henrynester/FIRES-hardware/battery-board.kicad_pcb

## KiCad design battery-board.kicad_pcb (2025-03-20)

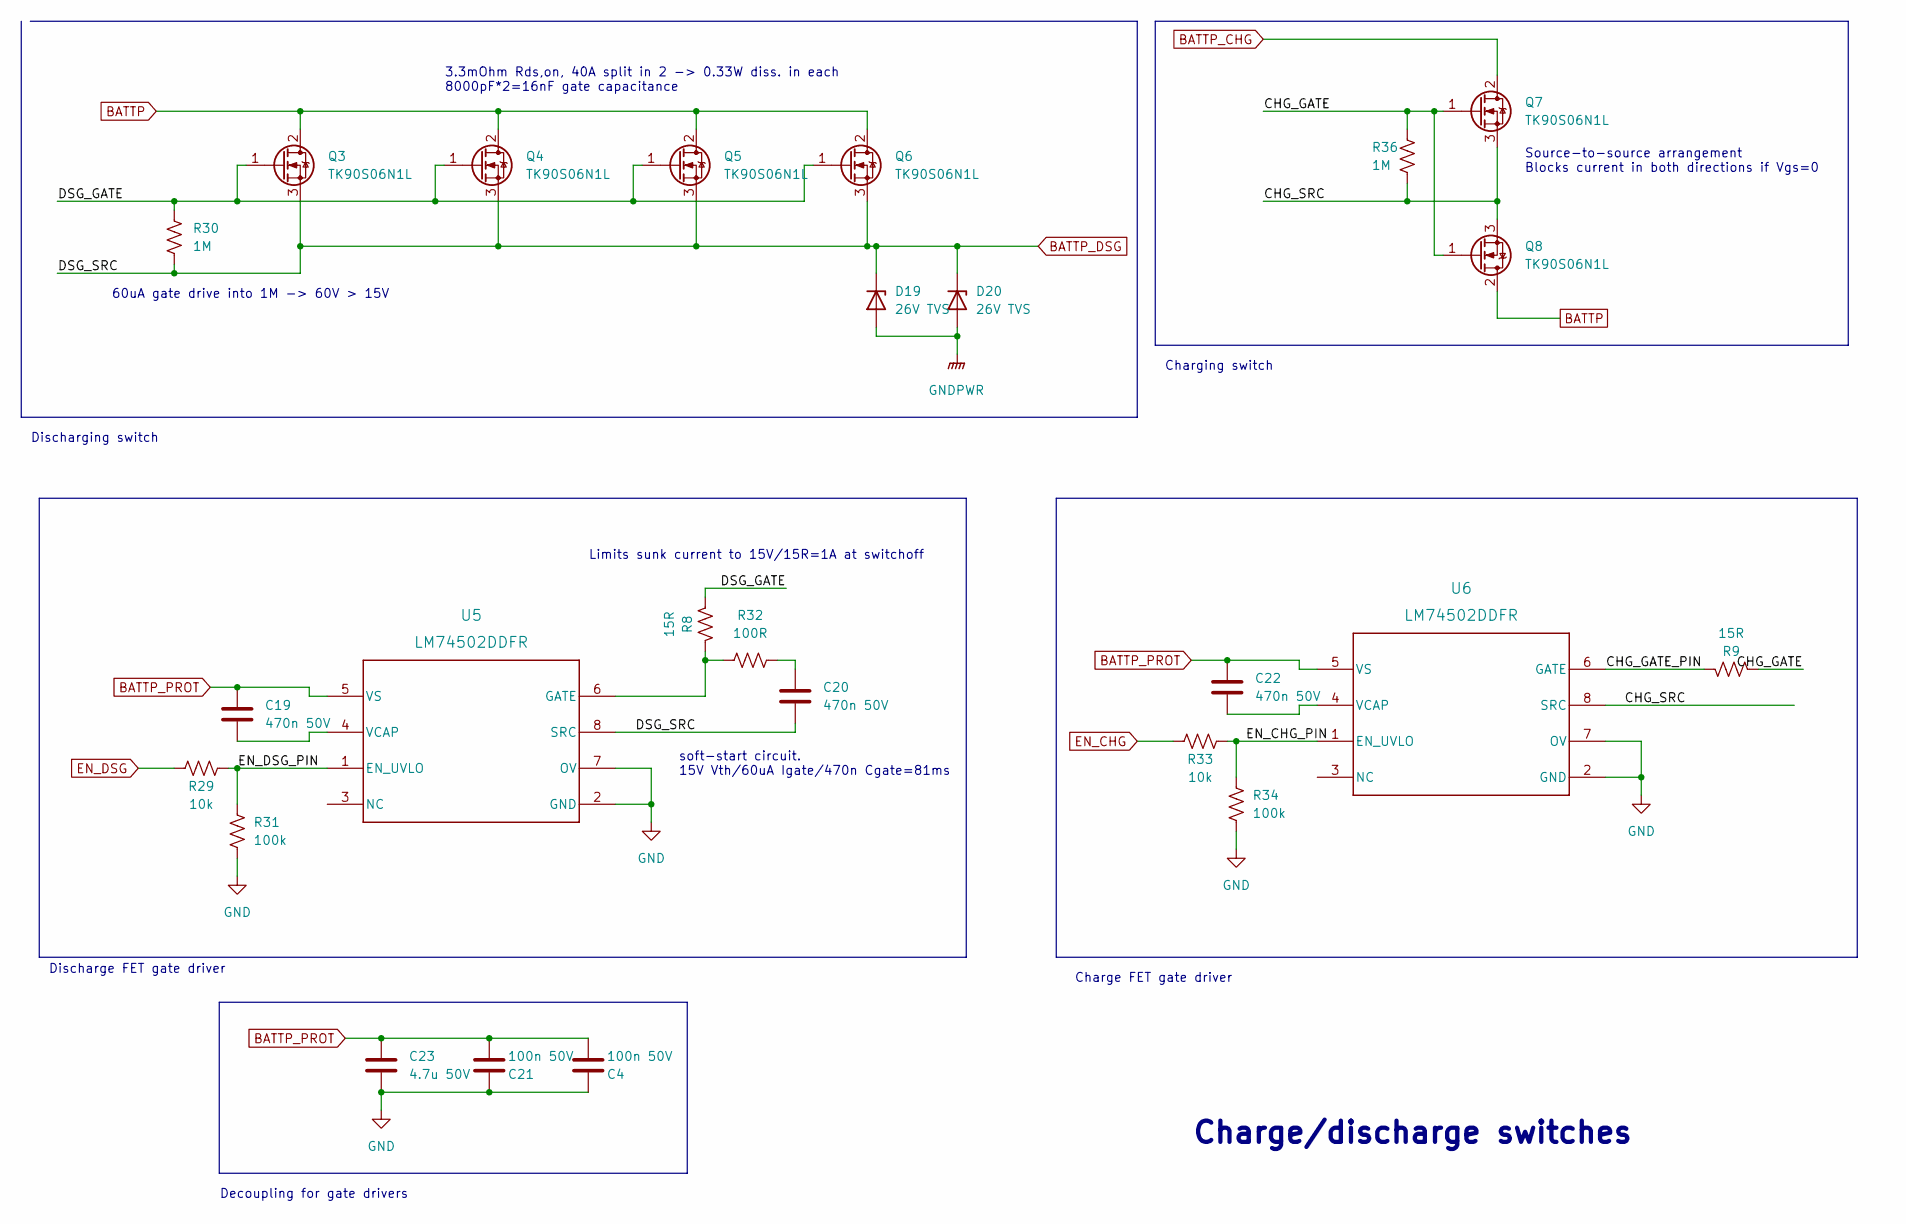
[picture p9: schematic load_switch.kicad_sch]

Parts:
C4, C21: 100n 50V; C_0805_2012Metric; part_number GCD21BR71H104KA01L
C19, C20, C22: 470n 50V; C_0805_2012Metric_Pad1.18x1.45mm_HandSolder; part_number GRM21BR71H474KA88L
C23: 4.7u 50V; C_1206_3216Metric_Pad1.33x1.80mm_HandSolder; part_number GRM31CR71H475KA12L
D19, D20: 26V TVS; D_SMB; part_number SMBJ26A
Q3, Q4, Q5, Q6, Q7, Q8: TK90S06N1L; TO-252-2; part_number TK90S06N1L,LXHQ
R8, R9: 15R; R_0805_2012Metric_Pad1.20x1.40mm_HandSolder; part_number RC0805FR-1310KL
R29, R33: 10k; R_0805_2012Metric_Pad1.20x1.40mm_HandSolder; part_number RC0805FR-1310KL
R30, R36: 1M; R_0805_2012Metric_Pad1.20x1.40mm_HandSolder; part_number RC0805FR-071ML
R31, R34: 100k; R_0805_2012Metric_Pad1.20x1.40mm_HandSolder; part_number RC0805FR-07100KL
R32: 100R; R_0805_2012Metric_Pad1.20x1.40mm_HandSolder; part_number RC0805FR-07100RL
U5, U6: LM74502DDFR; LM74502; part_number LM74502DDFR

Connections:
/load_switch/CHG_GATE: Q7.1 (G), Q8.1 (G), R9.2, R36.1
/load_switch/CHG_GATE_PIN: R9.1, U6.6 (GATE)
/load_switch/CHG_SRC: Q7.3 (S), Q8.3 (S), R36.2, U6.8 (SRC)
/load_switch/DSG_GATE: Q3.1 (G), Q4.1 (G), Q5.1 (G), Q6.1 (G), R8.2, R30.1
/load_switch/EN_CHG_PIN: R33.2, R34.1, U6.1 (EN_UVLO)
/load_switch/EN_DSG_PIN: R29.2, R31.1, U5.1 (EN_UVLO)
BATTN: C4.1, C21.1, C23.2, R31.2, R34.2, U5.2 (GND), U5.7 (OV), U6.2 (GND), U6.7 (OV); also elsewhere on the board
BATTP: Q3.2 (D), Q4.2 (D), Q5.2 (D), Q6.2 (D), Q8.2 (D); also elsewhere on the board
BATTP_CHG: Q7.2 (D); also elsewhere on the board
BATTP_DSG: C20.2, D19.1 (K), D20.1 (K), Q3.3 (S), Q4.3 (S), Q5.3 (S), Q6.3 (S), R30.2, U5.8 (SRC); also elsewhere on the board
BATTP_PROT: C4.2, C19.1, C21.2, C22.1, C23.1, U5.5 (VS), U6.5 (VS); also elsewhere on the board
EN_CHG: R33.1; also elsewhere on the board
EN_DSG: R29.1; also elsewhere on the board
GNDPWR: D19.2 (A), D20.2 (A); also elsewhere on the board
unnamed: C19.2, U5.4 (VCAP)
unnamed: C20.1, R32.2
unnamed: C22.2, U6.4 (VCAP)
unnamed: R8.1, R32.1, U5.6 (GATE)

Notes on the sheet:
Charge FET gate driver
Decoupling for gate drivers
soft-start circuit. 15V Vth/60uA Igate/470n Cgate=81ms
Charging switch
Charge/discharge switches
Discharging switch
Discharge FET gate driver
Source-to-source arrangement Blocks current in both directions if Vgs=0
Limits sunk current to 15V/15R=1A at switchoff
60uA gate drive into 1M -> 60V > 15V
3.3mOhm Rds,on, 40A split in 2 -> 0.33W diss. in each 8000pF*2=16nF gate capacitance

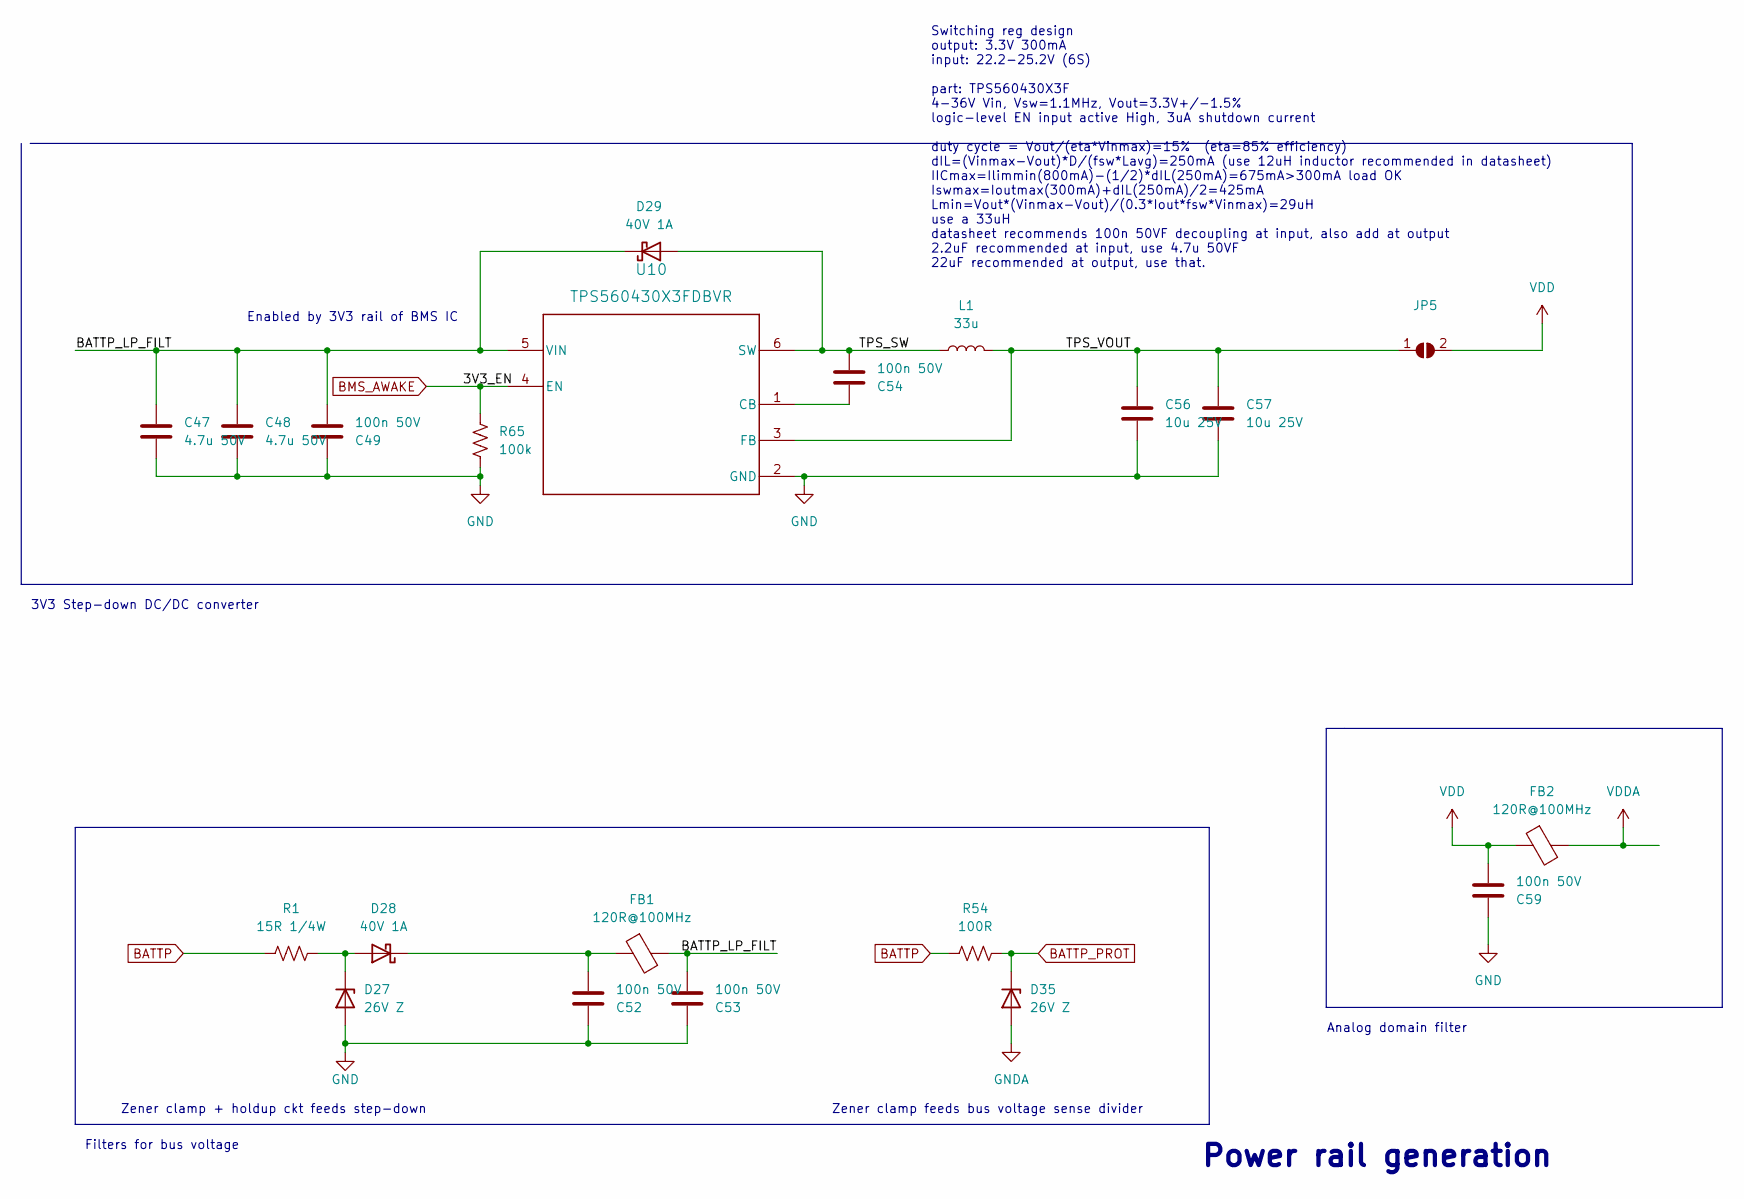
[picture p10: schematic rails.kicad_sch]

Parts:
C47, C48: 4.7u 50V; C_1206_3216Metric_Pad1.33x1.80mm_HandSolder; part_number GRM31CR71H475KA12L
C49, C52, C53, C54, C59: 100n 50V; C_0805_2012Metric; part_number GCD21BR71H104KA01L
C56, C57: 10u 25V; C_1206_3216Metric_Pad1.33x1.80mm_HandSolder; part_number GRM31CR71E106KA12L
D27, D35: 26V Z; D_SOD-123; part_number DDZ26-7
D28, D29: 40V 1A; D_SOD-323_HandSoldering; part_number 1N5819WS
FB1, FB2: 120R@100MHz; R_0805_2012Metric; part_number HI0805O121R-10
JP5: SolderJumper-2_P1.3mm_Open_Pad1.0x1.5mm
L1: 33u; L_Taiyo-Yuden_NR-60xx; part_number NR6028T330M
R1: 15R 1/4W; R_0805_2012Metric_Pad1.20x1.40mm_HandSolder; part_number AC0805FR-7W15RL
R54: 100R; R_0805_2012Metric_Pad1.20x1.40mm_HandSolder; part_number RC0805FR-07100RL
R65: 100k; R_0805_2012Metric_Pad1.20x1.40mm_HandSolder; part_number RC0805FR-07100KL
U10: TPS560430X3FDBVR; SOT-23-6_Handsoldering; part_number TPS560430X3FDBVR

Connections:
/rails/BATTP_LP_FILT: C47.1, C48.1, C49.2, C53.2, D29.1 (K), FB1.2, U10.5 (VIN)
/rails/TPS_SW: C54.2, D29.2 (A), L1.1, U10.6 (SW)
/rails/TPS_VOUT: C56.1, C57.1, JP5.1 (A), L1.2, U10.3 (FB)
BATTN: C47.2, C48.2, C49.1, C52.1, C53.1, C56.2, C57.2, C59.1, D27.2 (A), D35.2 (A), R65.1, U10.2 (GND); also elsewhere on the board
BATTP: R1.1, R54.1; also elsewhere on the board
BATTP_PROT: D35.1 (K), R54.2; also elsewhere on the board
BMS_AWAKE: R65.2, U10.4 (EN); also elsewhere on the board
unnamed: C52.2, D28.1 (K), FB1.1
unnamed: C54.1, U10.1 (CB)
unnamed: D27.1 (K), D28.2 (A), R1.2
VDD: C59.2, FB2.1, JP5.2 (B); also elsewhere on the board
VDDA: FB2.2; also elsewhere on the board

Notes on the sheet:
3V3 Step-down DC/DC converter
Analog domain filter
Zener clamp feeds bus voltage sense divider
Power rail generation
Switching reg design output: 3.3V 300mA input: 22.2-25.2V (6S) part: TPS560430X3F 4-36V Vin, Vsw=1.1MHz, Vout=3.3V+/-1.5% logic-level EN input active High, 3uA shutdown current duty cycle = Vout/(eta*Vinmax)=15% (eta=85% efficiency) dIL=(Vinmax-Vout)*D/(fsw*Lavg)=250mA (use 12uH inductor recommende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
Filters for bus voltage
Zener clamp + holdup ckt feeds step-down
Enabled by 3V3 rail of BMS IC

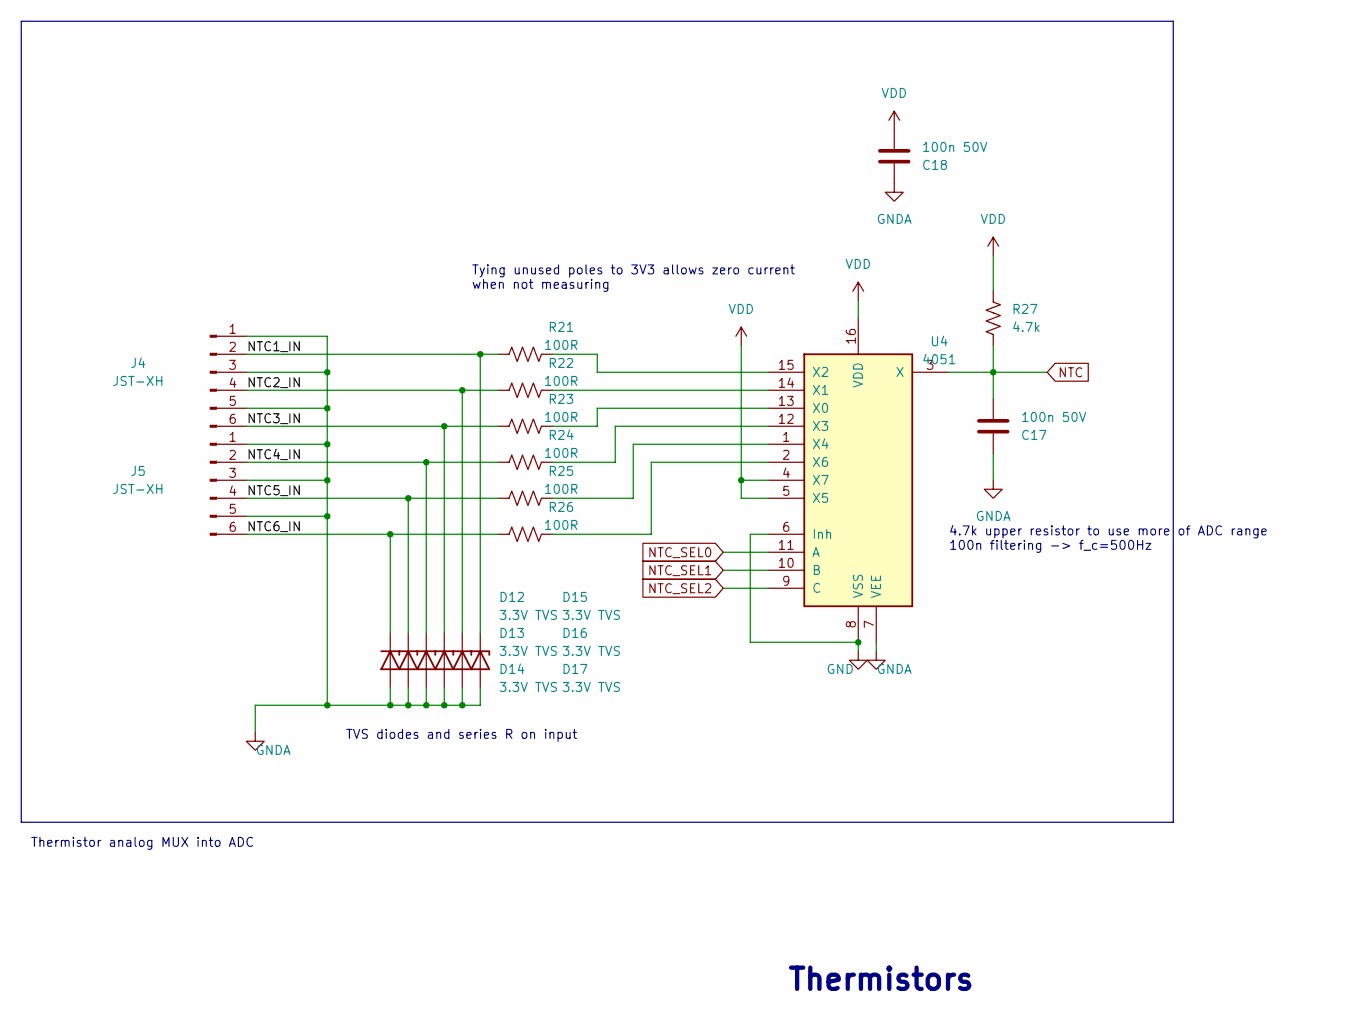
[picture p11: schematic thermistors.kicad_sch]

Parts:
C17, C18: 100n 50V; C_0805_2012Metric; part_number GCD21BR71H104KA01L
D12, D13, D14, D15, D16, D17: 3.3V TVS; D_SOD-323_HandSoldering; part_number ESD5Z3.3T5G
J4, J5: JST-XH; JST_XH_B6B-XH-A_1x06_P2.50mm_Vertical
R21, R22, R23, R24, R25, R26: 100R; R_0805_2012Metric_Pad1.20x1.40mm_HandSolder; part_number RC0805FR-07100RL
R27: 4.7k; R_0805_2012Metric_Pad1.20x1.40mm_HandSolder; part_number RC0805FR-074K7L
U4: 4051; TSSOP-16_4.4x5mm_P0.65mm; part_number CD74HC4051PWR

Connections:
/thermistors/NTC1_IN: D17.1 (K), J4.2, R21.2
/thermistors/NTC2_IN: D16.1 (K), J4.4, R22.2
/thermistors/NTC3_IN: D15.1 (K), J4.6, R23.2
/thermistors/NTC4_IN: D14.1 (K), J5.2, R24.2
/thermistors/NTC5_IN: D13.1 (K), J5.4, R25.2
/thermistors/NTC6_IN: D12.1 (K), J5.6, R26.2
BATTN: C17.1, C18.1, D12.2 (A), D13.2 (A), D14.2 (A), D15.2 (A), D16.2 (A), D17.2 (A), J4.1, J4.3, J4.5, J5.1, J5.3, J5.5, U4.6 (Inh), U4.7 (VEE), U4.8 (VSS); also elsewhere on the board
NTC: C17.2, R27.2, U4.3 (X); also elsewhere on the board
NTC_SEL0: U4.11 (A); also elsewhere on the board
NTC_SEL1: U4.10 (B); also elsewhere on the board
NTC_SEL2: U4.9 (C); also elsewhere on the board
unnamed: R21.1, U4.15 (X2)
unnamed: R22.1, U4.14 (X1)
unnamed: R23.1, U4.13 (X0)
unnamed: R24.1, U4.12 (X3)
unnamed: R25.1, U4.1 (X4)
unnamed: R26.1, U4.2 (X6)
VDD: C18.2, R27.1, U4.4 (X7), U4.5 (X5), U4.16 (VDD); also elsewhere on the board

Notes on the sheet:
TVS diodes and series R on input
4.7k upper resistor to use more of ADC range 100n filtering -> f_c=500Hz
Tying unused poles to 3V3 allows zero current when not measuring
Thermistors
Thermistor analog MUX into ADC

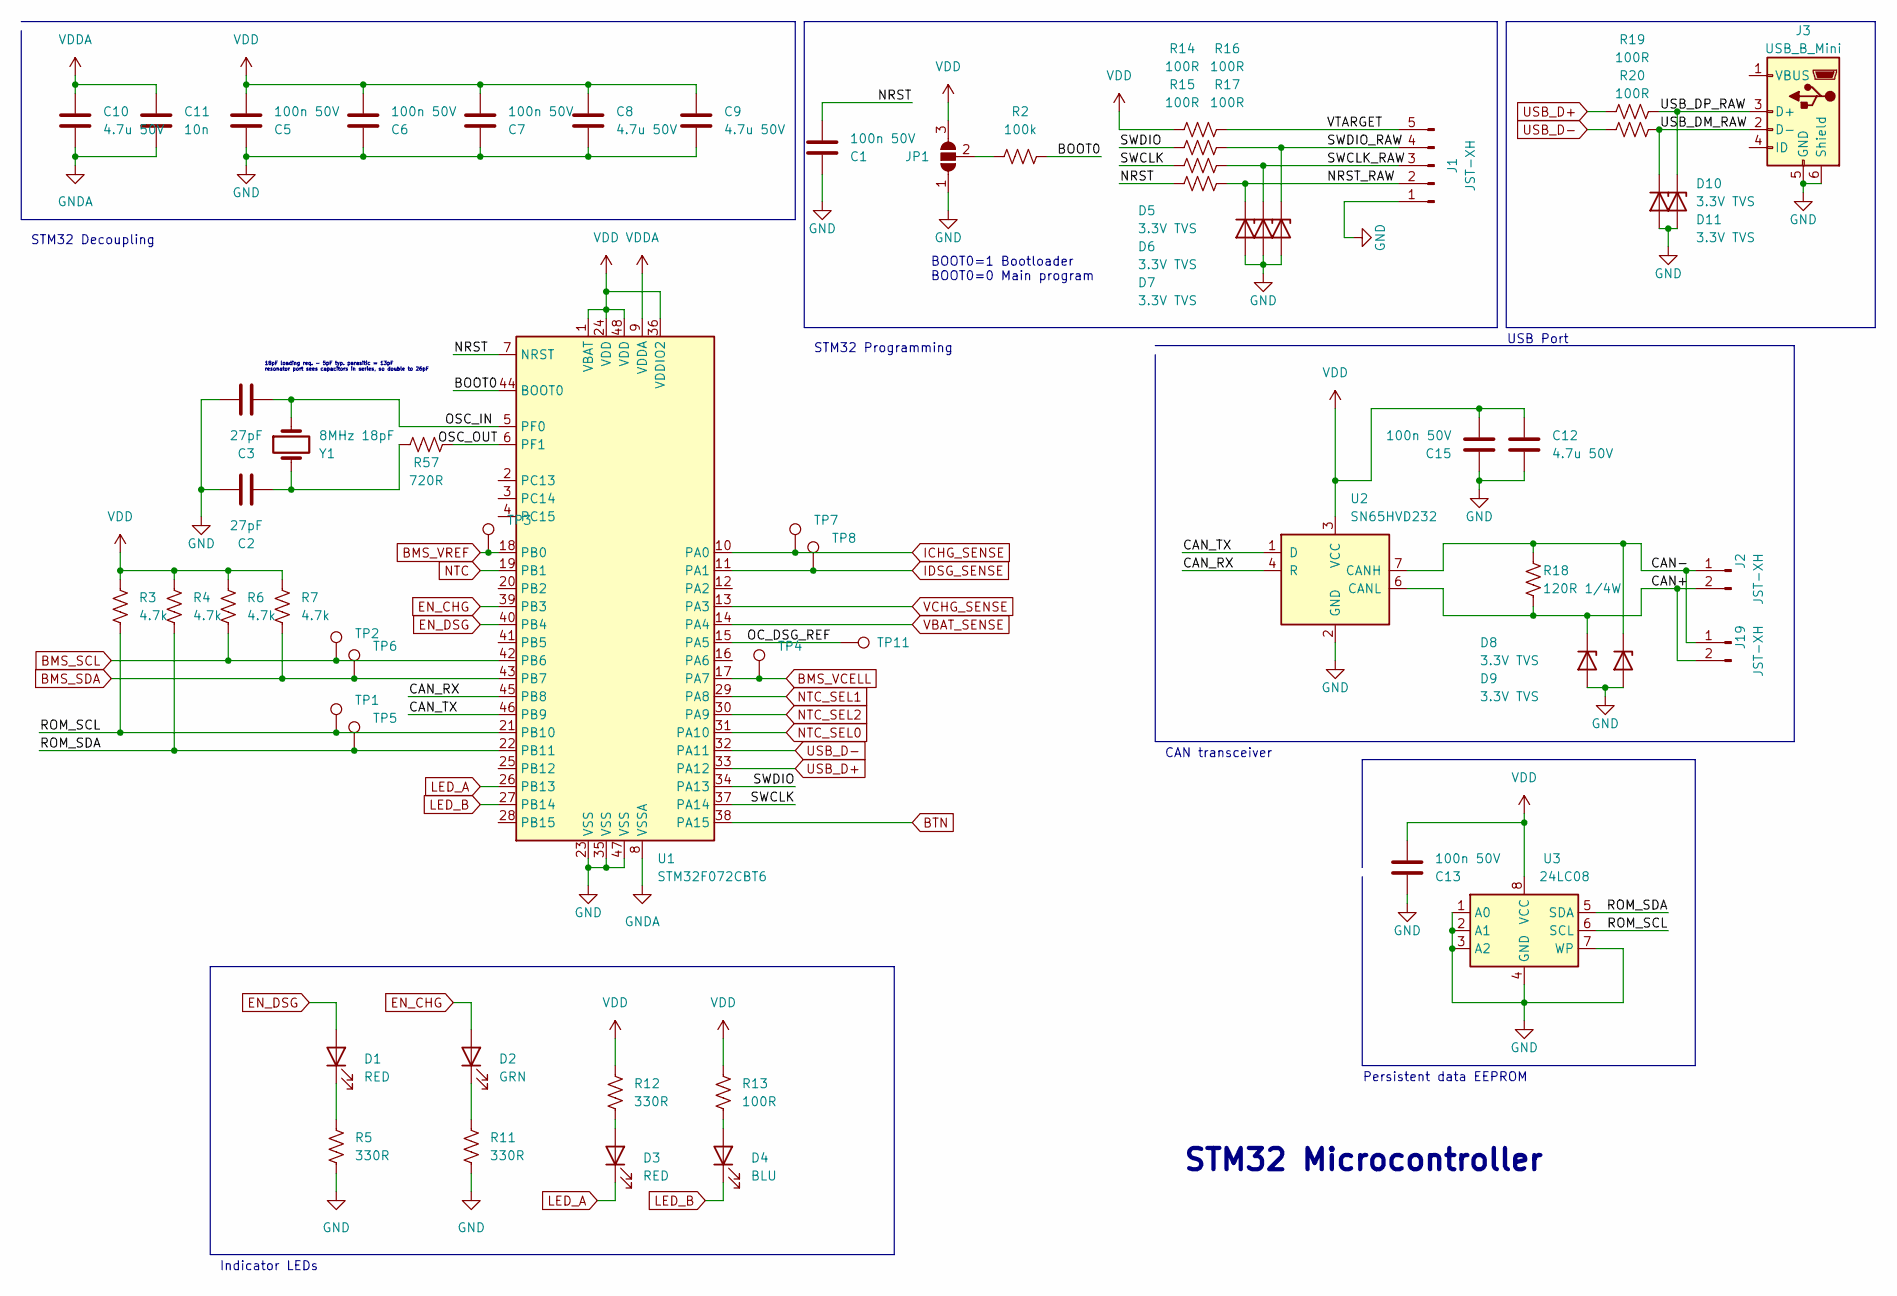
[picture p12: schematic MCU.kicad_sch]

Parts:
C1, C5, C6, C7, C13, C15: 100n 50V; C_0805_2012Metric; part_number GCD21BR71H104KA01L
C2, C3: 27pF; C_0805_2012Metric_Pad1.18x1.45mm_HandSolder; part_number CC0805FRNPO9BN270
C8, C9, C10, C12: 4.7u 50V; C_1206_3216Metric_Pad1.33x1.80mm_HandSolder; part_number GRM31CR71H475KA12L
C11: 10n; R_0805_2012Metric_Pad1.20x1.40mm_HandSolder; part_number GCM219R71H103KA37D
D1, D3: RED; LED_0805_2012Metric_Pad1.15x1.40mm_HandSolder; part_number LTST-C171KRKT
D2: GRN; LED_0805_2012Metric_Pad1.15x1.40mm_HandSolder; part_number LTST-C171GKT
D4: BLU; LED_0805_2012Metric_Pad1.15x1.40mm_HandSolder; part_number LTST-C171TBKT
D5, D6, D7, D8, D9, D10, D11: 3.3V TVS; D_SOD-323_HandSoldering; part_number ESD5Z3.3T5G
J1: JST-XH; PinHeader_1x05_P2.54mm_Vertical
J2, J19: JST-XH; JST_XH_B2B-XH-A_1x02_P2.50mm_Vertical
J3: USB_B_Mini; USB_Mini-B_Tensility_54-00023_Vertical; part_number 54-00023
JP1: SolderJumper-3_P1.3mm_Open_Pad1.0x1.5mm
R2: 100k; R_0805_2012Metric_Pad1.20x1.40mm_HandSolder; part_number RC0805FR-07100KL
R3, R4, R6, R7: 4.7k; R_0805_2012Metric_Pad1.20x1.40mm_HandSolder; part_number RC0805FR-074K7L
R5, R11, R12: 330R; R_0805_2012Metric_Pad1.20x1.40mm_HandSolder; part_number RC0805FR-07100RL
R13, R14, R15, R16, R17, R19, R20: 100R; R_0805_2012Metric_Pad1.20x1.40mm_HandSolder; part_number RC0805FR-07100RL
R18: 120R 1/4W; R_0805_2012Metric_Pad1.20x1.40mm_HandSolder; part_number RC0805FR-7W120RL
R57: 720R; R_0805_2012Metric_Pad1.20x1.40mm_HandSolder; part_number RC0805FR-07100RL
TP1, TP2, TP3, TP4, TP5, TP6, TP7, TP8: PinHeader_1x01_P1.00mm_Vertical
TP11: TestPoint; TestPoint_Pad_D1.0mm
U1: STM32F072CBT6; LQFP-48_7x7mm_P0.5mm; part_number STM32F072CBT6
U2: SN65HVD232; SOIC-8_3.9x4.9mm_P1.27mm; part_number SN65HVD232
U3: 24LC08; SOIC-8_3.9x4.9mm_P1.27mm; part_number 24LC08BT-I/SN
Y1: 8MHz 18pF; Crystal_SMD_HC49-SD; part_number ABLS-8.000MHZ-D-T

Connections:
/MCU/BOOT0: R2.2, U1.44 (BOOT0)
/MCU/CAN+: D8.1 (K), J2.2, J19.2, R18.2, U2.6 (CANL)
/MCU/CAN-: D9.1 (K), J2.1, J19.1, R18.1, U2.7 (CANH)
/MCU/CAN_RX: U1.45 (PB8), U2.4 (R)
/MCU/CAN_TX: U1.46 (PB9), U2.1 (D)
/MCU/NRST: C1.2, R17.2, U1.7 (NRST)
/MCU/NRST_RAW: D5.1 (K), J1.2, R17.1
/MCU/OC_DSG_REF: TP11.1, U1.15 (PA5)
/MCU/OSC_IN: C3.2, U1.5 (PF0), Y1.1
/MCU/OSC_OUT: R57.2, U1.6 (PF1)
/MCU/ROM_SCL: R3.2, TP1.1, U1.21 (PB10), U3.6 (SCL)
/MCU/ROM_SDA: R4.2, TP5.1, U1.22 (PB11), U3.5 (SDA)
/MCU/SWCLK: R16.2, U1.37 (PA14)
/MCU/SWCLK_RAW: D6.1 (K), J1.3, R16.1
/MCU/SWDIO: R15.2, U1.34 (PA13)
/MCU/SWDIO_RAW: D7.1 (K), J1.4, R15.1
/MCU/USB_DM_RAW: D10.1 (K), J3.2 (D-), R20.1
/MCU/USB_DP_RAW: D11.1 (K), J3.3 (D+), R19.1
/MCU/VTARGET: J1.5, R14.1
BATTN: C1.1, C2.1, C3.1, C5.1, C6.1, C7.1, C8.2, C9.2, C10.2, C11.2, C12.2, C13.1, C15.1, D5.2 (A), D6.2 (A), D7.2 (A), D8.2 (A), D9.2 (A), D10.2 (A), D11.2 (A), J1.1, J3.5 (GND), J3.6 (Shield), JP1.1 (A), R5.1, R11.1, U1.8 (VSSA), U1.23 (VSS), U1.35 (VSS), U1.47 (VSS), U2.2 (GND), U3.1 (A0), U3.2 (A1), U3.3 (A2), U3.4 (GND), U3.7 (WP); also elsewhere on the board
BMS_SCL: R6.2, TP2.1, U1.42 (PB6); also elsewhere on the board
BMS_SDA: R7.2, TP6.1, U1.43 (PB7); also elsewhere on the board
BMS_VCELL: TP4.1, U1.17 (PA7); also elsewhere on the board
BMS_VREF: TP3.1, U1.18 (PB0); also elsewhere on the board
BTN: U1.38 (PA15); also elsewhere on the board
EN_CHG: D2.2 (A), U1.39 (PB3); also elsewhere on the board
EN_DSG: D1.2 (A), U1.40 (PB4); also elsewhere on the board
ICHG_SENSE: TP7.1, U1.10 (PA0); also elsewhere on the board
IDSG_SENSE: TP8.1, U1.11 (PA1); also elsewhere on the board
LED_A: D3.1 (K), U1.26 (PB13)
LED_B: D4.1 (K), U1.27 (PB14)
NTC: U1.19 (PB1); also elsewhere on the board
NTC_SEL0: U1.31 (PA10); also elsewhere on the board
NTC_SEL1: U1.29 (PA8); also elsewhere on the board
NTC_SEL2: U1.30 (PA9); also elsewhere on the board
unnamed: C2.2, R57.1, Y1.2
unnamed: D1.1 (K), R5.2
unnamed: D2.1 (K), R11.2
unnamed: D3.2 (A), R12.1
unnamed: D4.2 (A), R13.1
unnamed: JP1.2 (C), R2.1
USB_D+: R19.2, U1.33 (PA12)
USB_D-: R20.2, U1.32 (PA11)
VBAT_SENSE: U1.14 (PA4); also elsewhere on the board
VCHG_SENSE: U1.13 (PA3); also elsewhere on the board
VDD: C5.2, C6.2, C7.2, C8.1, C9.1, C12.1, C13.2, C15.2, JP1.3 (B), R3.1, R4.1, R6.1, R7.1, R12.2, R13.2, R14.2, U1.1 (VBAT), U1.24 (VDD), U1.36 (VDDIO2), U1.48 (VDD), U2.3 (VCC), U3.8 (VCC); also elsewhere on the board
VDDA: C10.1, C11.1, U1.9 (VDDA); also elsewhere on the board

Notes on the sheet:
Persistent data EEPROM
USB Port
18pF loading req. - 5pF typ. parasitic = 13pF resonator port sees capacitors in series, so double to 26pF
BOOT0=1 Bootloader BOOT0=0 Main program
STM32 Programming
Indicator LEDs
CAN transceiver
STM32 Decoupling
STM32 Microcontroller

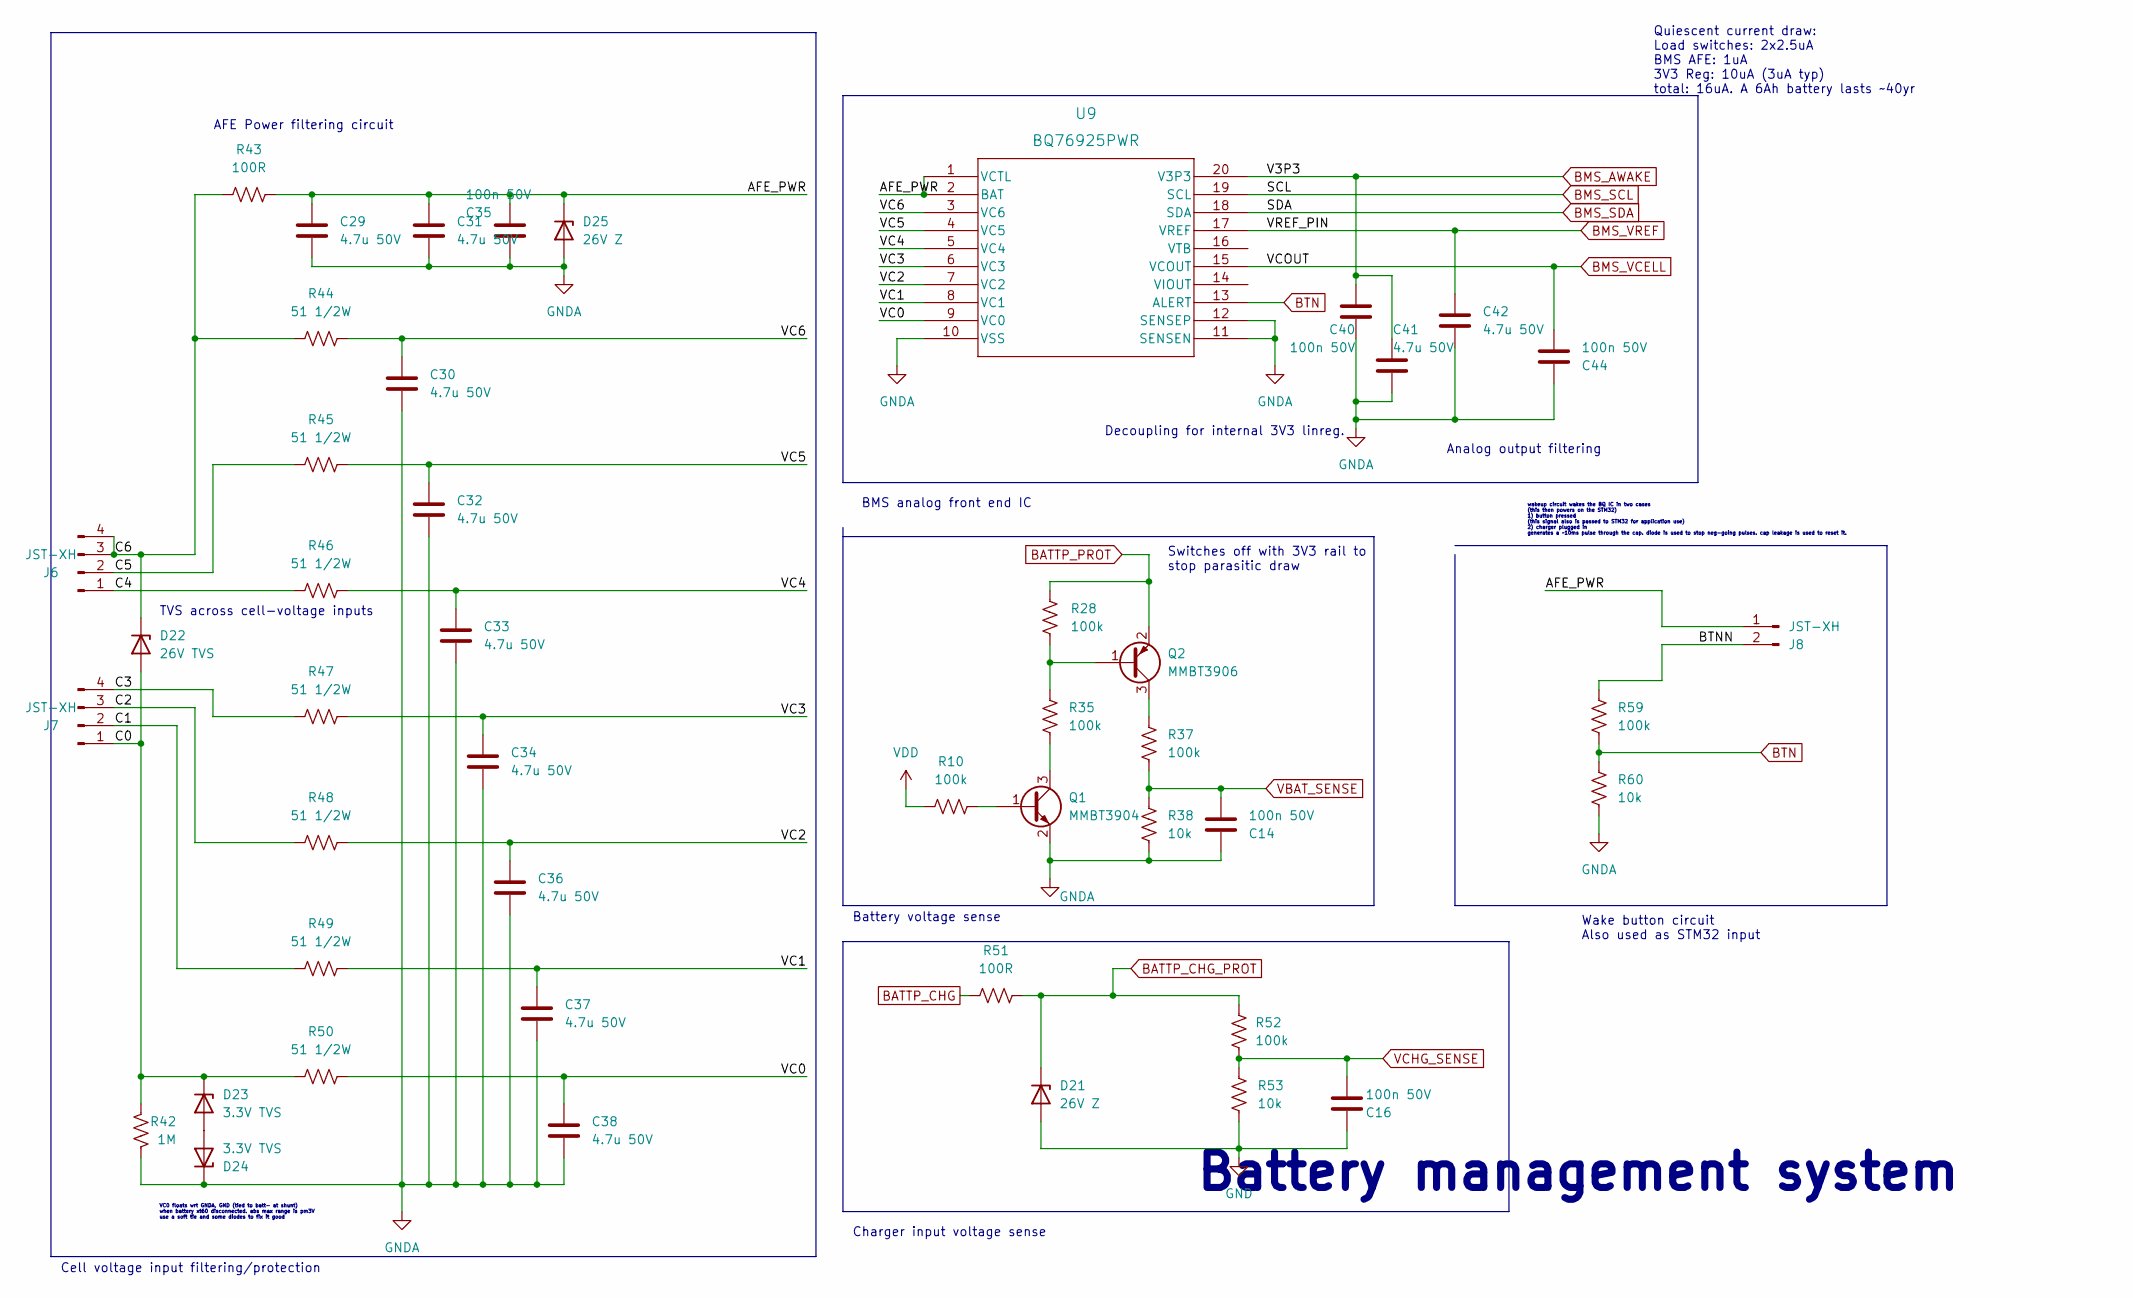
[picture p13: schematic battery_management.kicad_sch]

Parts:
C14, C16, C35, C40, C44: 100n 50V; C_0805_2012Metric; part_number GCD21BR71H104KA01L
C29, C30, C31, C32, C33, C34, C36, C37, C38, C41, C42: 4.7u 50V; C_1206_3216Metric_Pad1.33x1.80mm_HandSolder; part_number GRM31CR71H475KA12L
D21, D25: 26V Z; D_SOD-123; part_number DDZ26-7
D22: 26V TVS; D_SMB_Handsoldering; part_number SMBJ26A
D23, D24: 3.3V TVS; D_SOD-323_HandSoldering; part_number ESD5Z3.3T5G
J6, J7: JST-XH; JST_XH_B4B-XH-A_1x04_P2.50mm_Vertical
J8: JST-XH; JST_XH_B2B-XH-A_1x02_P2.50mm_Vertical
Q1: MMBT3904; SOT-23; part_number MMBT3904
Q2: MMBT3906; SOT-23; part_number MMBT3906
R10, R28, R35, R37, R52, R59: 100k; R_0805_2012Metric_Pad1.20x1.40mm_HandSolder; part_number RC0805FR-07100KL
R38, R53, R60: 10k; R_0805_2012Metric_Pad1.20x1.40mm_HandSolder; part_number RC0805FR-1310KL
R42: 1M; R_0805_2012Metric_Pad1.20x1.40mm_HandSolder; part_number RC0805FR-071ML
R43, R51: 100R; R_0805_2012Metric_Pad1.20x1.40mm_HandSolder; part_number RC0805FR-07100RL
R44, R45, R46, R47, R48, R49, R50: 51 1/2W; R_1206_3216Metric_Pad1.30x1.75mm_HandSolder; part_number CRM1206-FX-51R0ELF
U9: BQ76925PWR; BQ76925; part_number BQ76925PWR

Connections:
/battery_management/AFE_PWR: C29.1, C31.1, C35.2, D25.1 (K), J8.1, R43.2, U9.1 (VCTL), U9.2 (BAT)
/battery_management/BTNN: J8.2, R59.1
/battery_management/C0: D22.2 (A), D23.1 (K), J7.1, R42.1, R50.2
/battery_management/C1: J7.2, R49.2
/battery_management/C2: J7.3, R48.2
/battery_management/C3: J7.4, R47.2
/battery_management/C4: J6.1, R46.2
/battery_management/C5: J6.2, R45.2
/battery_management/C6: D22.1 (K), J6.3, J6.4, R43.1, R44.2
/battery_management/VC0: C38.1, R50.1, U9.9 (VC0)
/battery_management/VC1: C37.1, R49.1, U9.8 (VC1)
/battery_management/VC2: C36.1, R48.1, U9.7 (VC2)
/battery_management/VC3: C34.1, R47.1, U9.6 (VC3)
/battery_management/VC4: C33.1, R46.1, U9.5 (VC4)
/battery_management/VC5: C32.1, R45.1, U9.4 (VC5)
/battery_management/VC6: C30.1, R44.1, U9.3 (VC6)
BATTN: C14.1, C16.1, C29.2, C30.2, C31.2, C32.2, C33.2, C34.2, C35.1, C36.2, C37.2, C38.2, C40.1, C41.2, C42.2, C44.1, D21.2 (A), D24.1 (K), D25.2 (A), Q1.2 (E), R38.2, R42.2, R53.2, R60.2, U9.10 (VSS), U9.11 (SENSEN), U9.12 (SENSEP); also elsewhere on the board
BATTP_CHG: R51.1; also elsewhere on the board
BATTP_CHG_PROT: D21.1 (K), R51.2, R52.1
BATTP_PROT: Q2.2 (E), R28.2; also elsewhere on the board
BMS_AWAKE: C40.2, C41.1, U9.20 (V3P3); also elsewhere on the board
BMS_SCL: U9.19 (SCL); also elsewhere on the board
BMS_SDA: U9.18 (SDA); also elsewhere on the board
BMS_VCELL: C44.2, U9.15 (VCOUT); also elsewhere on the board
BMS_VREF: C42.1, U9.17 (VREF); also elsewhere on the board
BTN: R59.2, R60.1, U9.13 (ALERT); also elsewhere on the board
unnamed: D23.2 (A), D24.2 (A)
unnamed: Q1.1 (B), R10.2
unnamed: Q1.3 (C), R35.1
unnamed: Q2.1 (B), R28.1, R35.2
unnamed: Q2.3 (C), R37.2
VBAT_SENSE: C14.2, R37.1, R38.1; also elsewhere on the board
VCHG_SENSE: C16.2, R52.2, R53.1; also elsewhere on the board
VDD: R10.1; also elsewhere on the board

Notes on the sheet:
Battery voltage sense
Decoupling for internal 3V3 linreg.
Wake button circuit Also used as STM32 input
Cell voltage input filtering/protection
Switches off with 3V3 rail to stop parasitic draw
AFE Power filtering circuit
VC0 floats wrt GNDA, GND (tied to batt- at shunt) when battery xt60 disconnected. abs max range is pm3V use a soft tie and some diodes to fix it good
Quiescent current draw: Load switches: 2x2.5uA BMS AFE: 1uA 3V3 Reg: 10uA (3uA typ) total: 16uA. A 6Ah battery lasts ~40yr
TVS across cell-voltage inputs
Battery management system
Analog output filtering
BMS analog front end IC
Charger input voltage sense
wakeup circuit wakes the BQ IC in two cases (this then powers on the STM32) 1) button pressed (this signal also is passed to STM32 for application use) 2) charger plugged in generates a ~10ms pulse through the cap. diode is used to stop neg-going pulses. cap leakage is used to reset it.

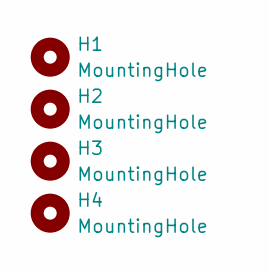
[picture p14: schematic mech.kicad_sch]

Parts:
H1, H2, H3, H4: MountingHole; MountingHole_3.2mm_M3

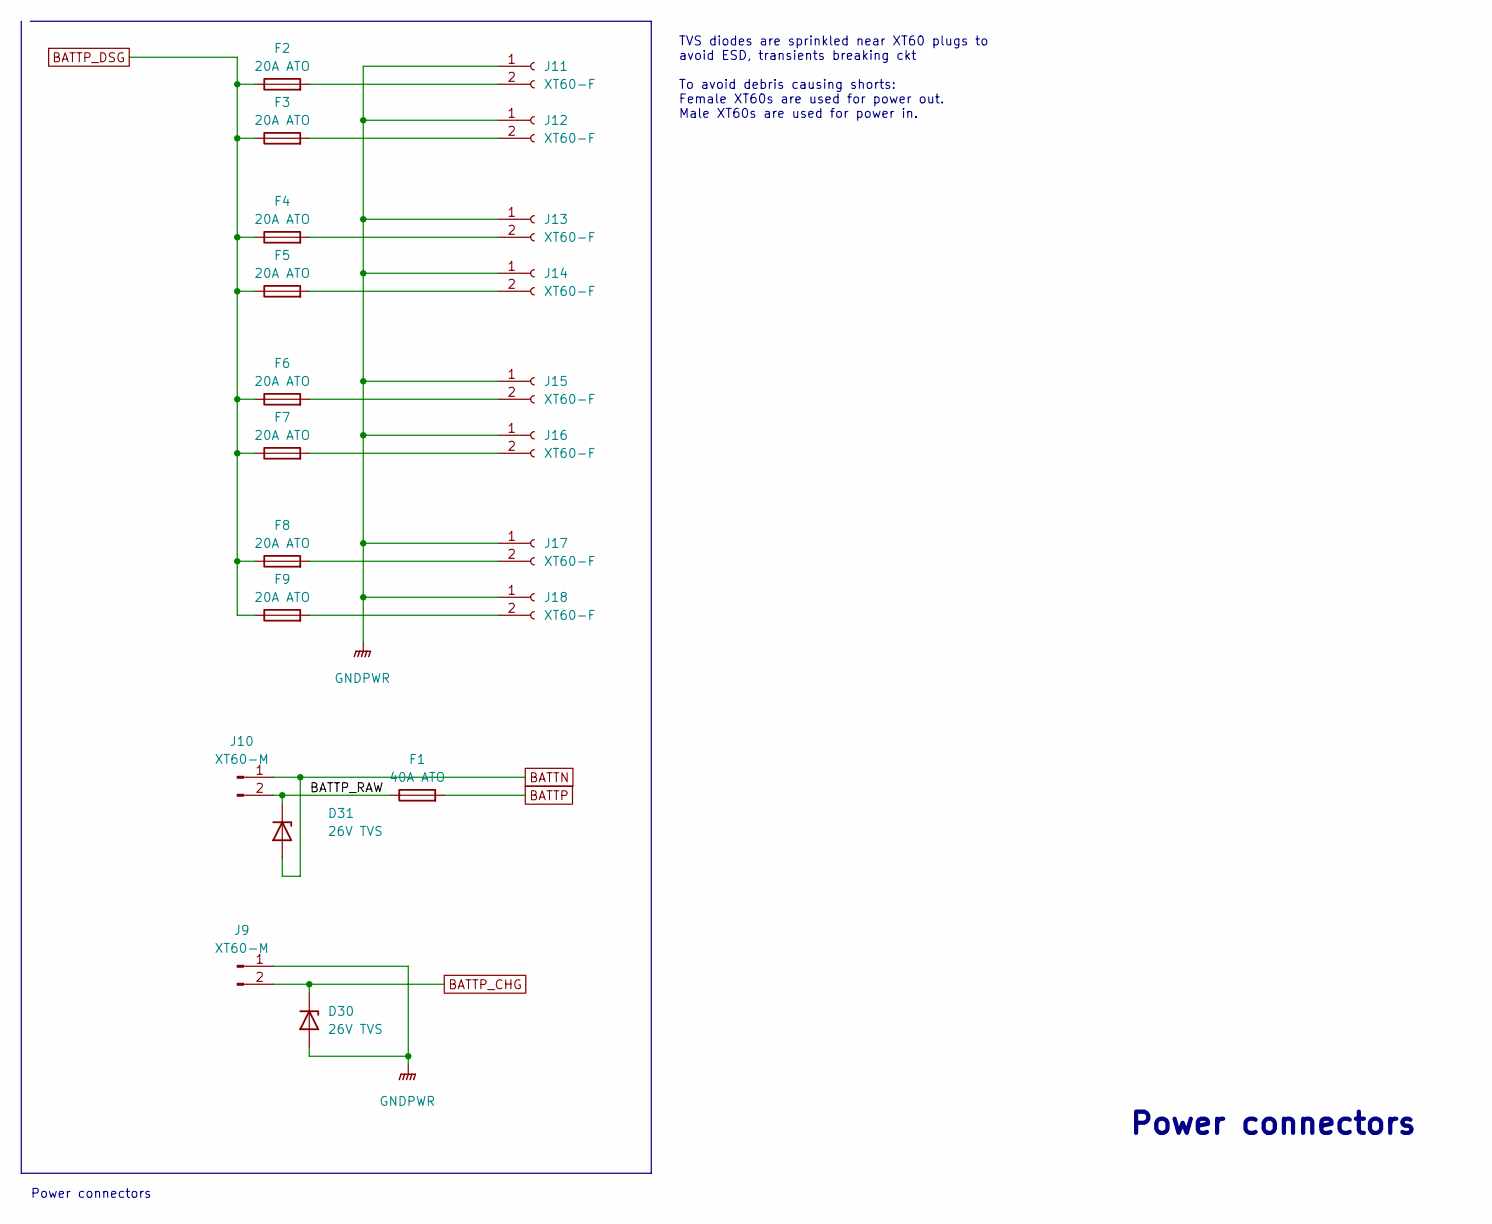
[picture p15: schematic power_connectors.kicad_sch]

Parts:
D30, D31: 26V TVS; D_SMB; part_number SMBJ26A
F1: 40A ATO; 3522-2; part_number 3522-2
F2, F3, F4, F5, F6, F7, F8, F9: 20A ATO; 3522-2; part_number 3522-2
J9, J10: XT60-M; AMASS_XT60-M_1x02_P7.20mm_Vertical
J11, J12, J13, J14, J15, J16, J17, J18: XT60-F; AMASS_XT60-F_1x02_P7.20mm_Vertical

Connections:
/power_connectors/BATTP_RAW: D31.1 (K), F1.1, J10.2
BATTN: D31.2 (A), J10.1; also elsewhere on the board
BATTP: F1.2; also elsewhere on the board
BATTP_CHG: D30.1 (K), J9.2; also elsewhere on the board
BATTP_DSG: F2.1, F3.1, F4.1, F5.1, F6.1, F7.1, F8.1, F9.1; also elsewhere on the board
GNDPWR: D30.2 (A), J9.1, J11.1, J12.1, J13.1, J14.1, J15.1, J16.1, J17.1, J18.1; also elsewhere on the board
unnamed: F2.2, J11.2
unnamed: F3.2, J12.2
unnamed: F4.2, J13.2
unnamed: F5.2, J14.2
unnamed: F6.2, J15.2
unnamed: F7.2, J16.2
unnamed: F8.2, J17.2
unnamed: F9.2, J18.2

Notes on the sheet:
TVS diodes are sprinkled near XT60 plugs to avoid ESD, transients breaking ckt To avoid debris causing shorts: Female XT60s are used for power out. Male XT60s are used for power in.
Power connectors
