henrynester/FIRES-hardware/battery-board.kicad_pcb

## KiCad design battery-board.kicad_pcb (continued)

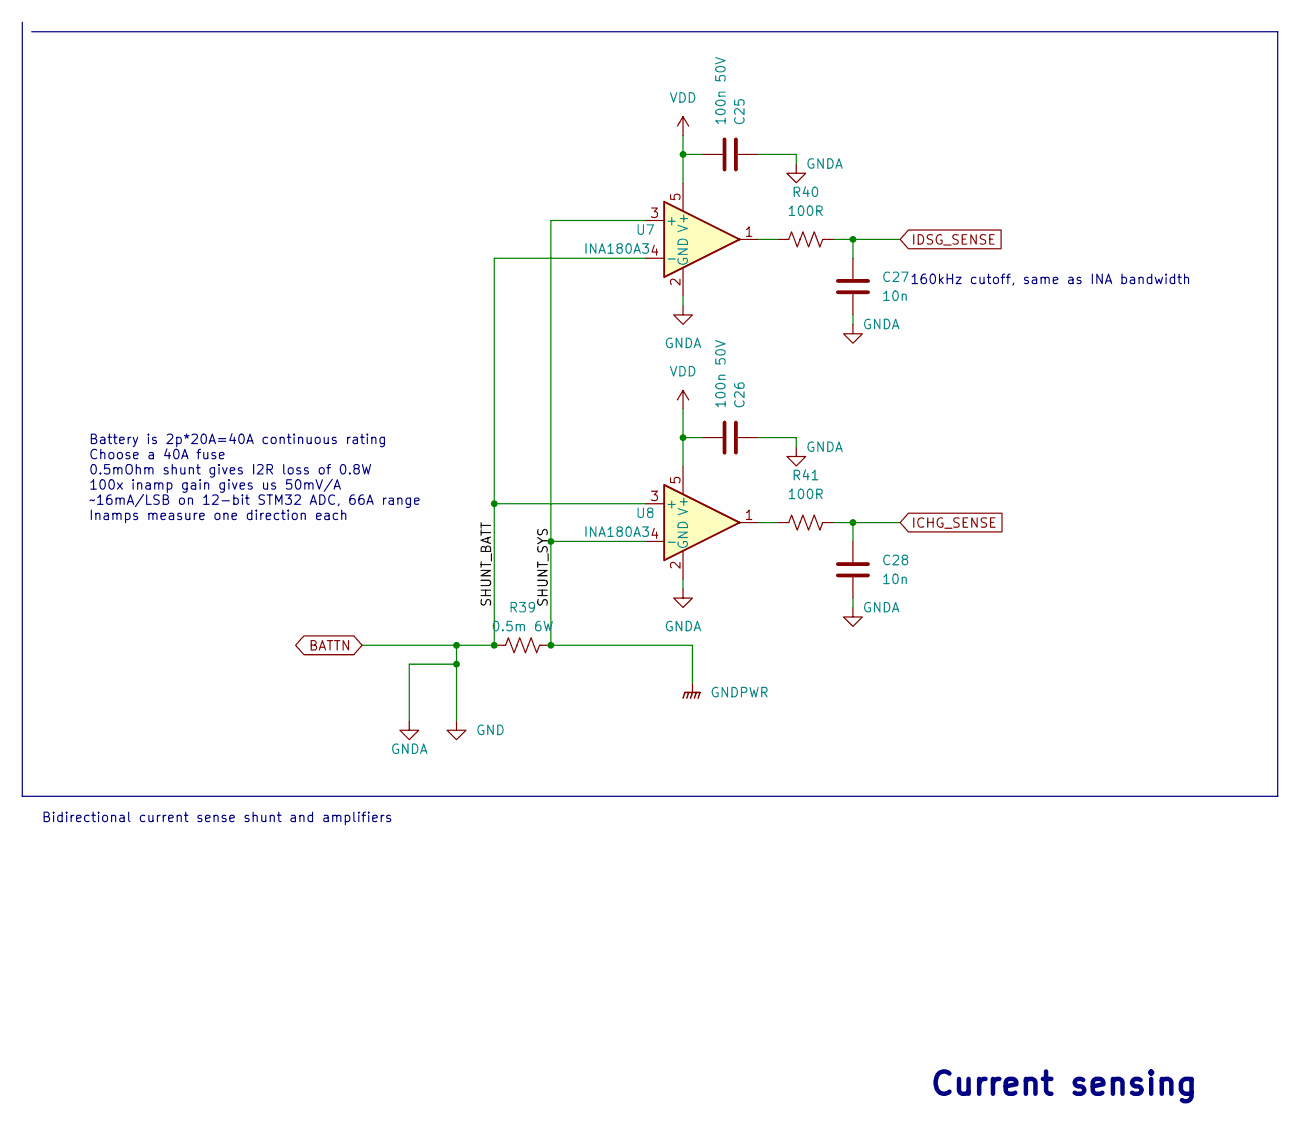
[picture p16: schematic current_sense.kicad_sch]

Parts:
C25, C26: 100n 50V; C_0805_2012Metric; part_number GCD21BR71H104KA01L
C27, C28: 10n; R_0805_2012Metric_Pad1.20x1.40mm_HandSolder; part_number GCM219R71H103KA37D
R39: 0.5m 6W; R_2512_6332Metric; part_number SSA2512L0M50FWR
R40, R41: 100R; R_0805_2012Metric_Pad1.20x1.40mm_HandSolder; part_number RC0805FR-07100RL
U7, U8: INA180A3; SOT-23-5; part_number INA180A3

Connections:
BATTN: C25.1, C26.1, C27.2, C28.2, R39.2, U7.2 (GND), U7.4 (-), U8.2 (GND), U8.3 (+); also elsewhere on the board
GNDPWR: R39.1, U7.3 (+), U8.4 (-); also elsewhere on the board
ICHG_SENSE: C28.1, R41.1; also elsewhere on the board
IDSG_SENSE: C27.1, R40.1; also elsewhere on the board
unnamed: R40.2, U7.1
unnamed: R41.2, U8.1
VDD: C25.2, C26.2, U7.5 (V+), U8.5 (V+); also elsewhere on the board

Notes on the sheet:
160kHz cutoff, same as INA bandwidth
Battery is 2p*20A=40A continuous rating Choose a 40A fuse 0.5mOhm shunt gives I2R loss of 0.8W 100x inamp gain gives us 50mV/A ~16mA/LSB on 12-bit STM32 ADC, 66A range Inamps measure one direction each
Current sensing
Bidirectional current sense shunt and amplifiers

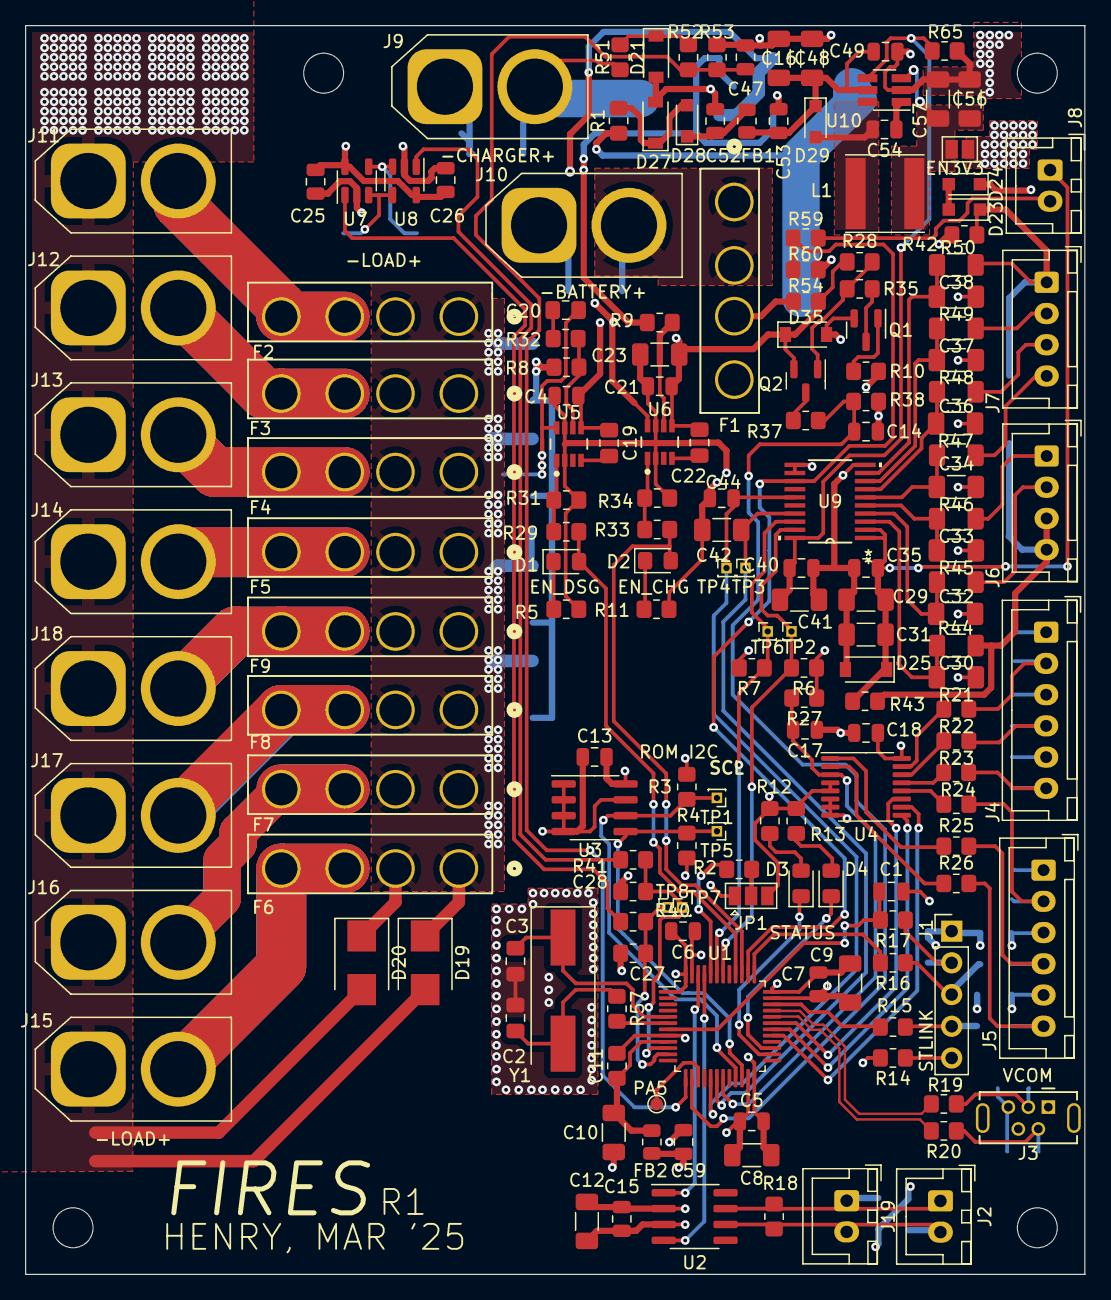
[picture p17: board battery-board.kicad_pcb from above]

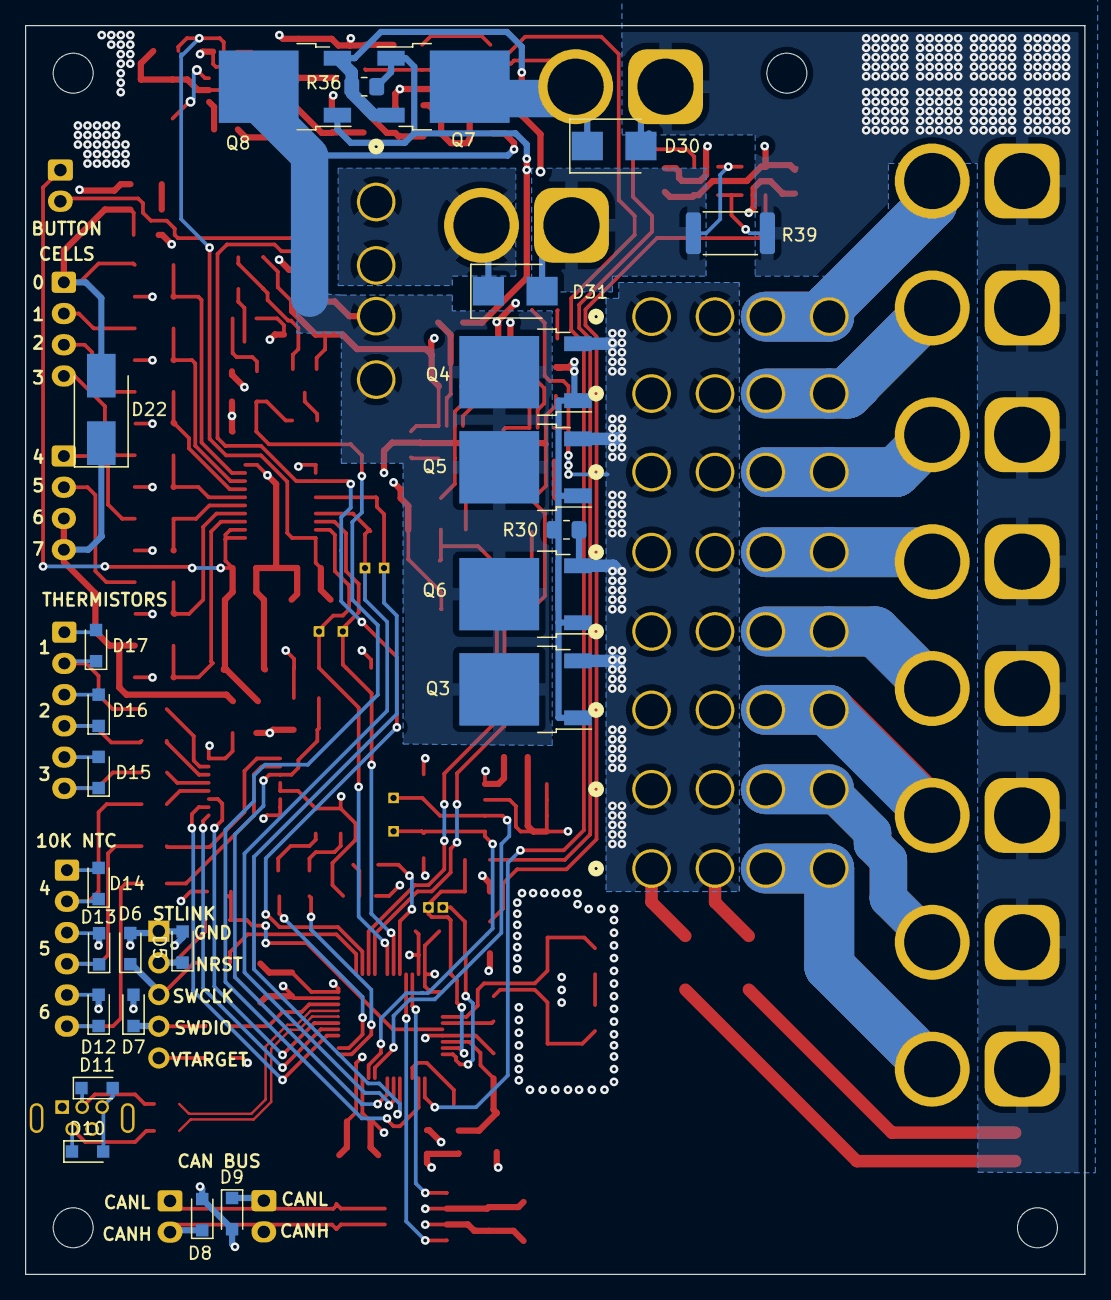
[picture p18: board battery-board.kicad_pcb from below]

Board: 4 copper layers, 84.8 x 100.0 mm, 203 parts (25 on the bottom side), 114 nets.
