henrynester/FIRES-hardware/(commit log)

2025-03-20 gerber output
    [battery-board-B_Cu.gbl, battery-board-B_Mask.gbs, battery-board-B_Silkscreen.gbo, battery-board-Edge_Cuts.gm1, battery-board-F_Cu.gtl, battery-board-F_Mask.gts, battery-board-F_Silkscreen.gto, battery-board-NPTH-drl_map.gbr]
2025-03-20 add sch
    [battery-board.kicad_pcb]
